BullMiletic/ProxistantVision/README.md

# ProxistantVision
Source files for BULL.MILETIC's installation [Proxistant Vision](https://bull.miletic.info/research/proxistant-vision).

Read about [Ferriscope](https://bull.miletic.info/works/ferriscope)

Read about [Venetie](https://bull.miletic.info/works/venetie-11111100001)
