BullMiletic/ProxistantVision/Ferriscope/datasheets/ArduinoMicroPinout.png

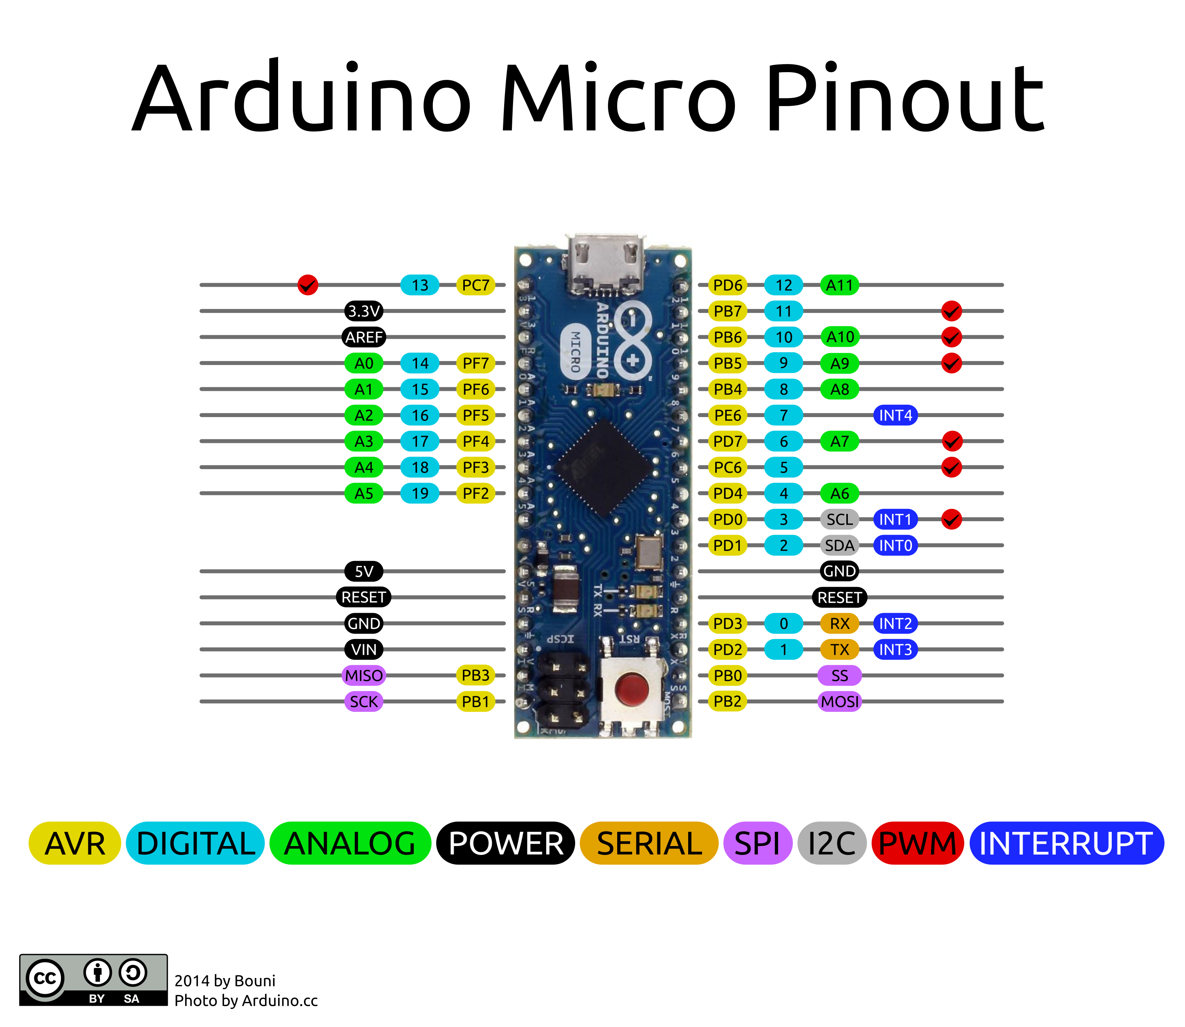
Ferriscope/datasheets/ArduinoMicroPinout.png
