BullMiletic/ProxistantVision/Ferriscope/PSI/kretskort/kontroller.png

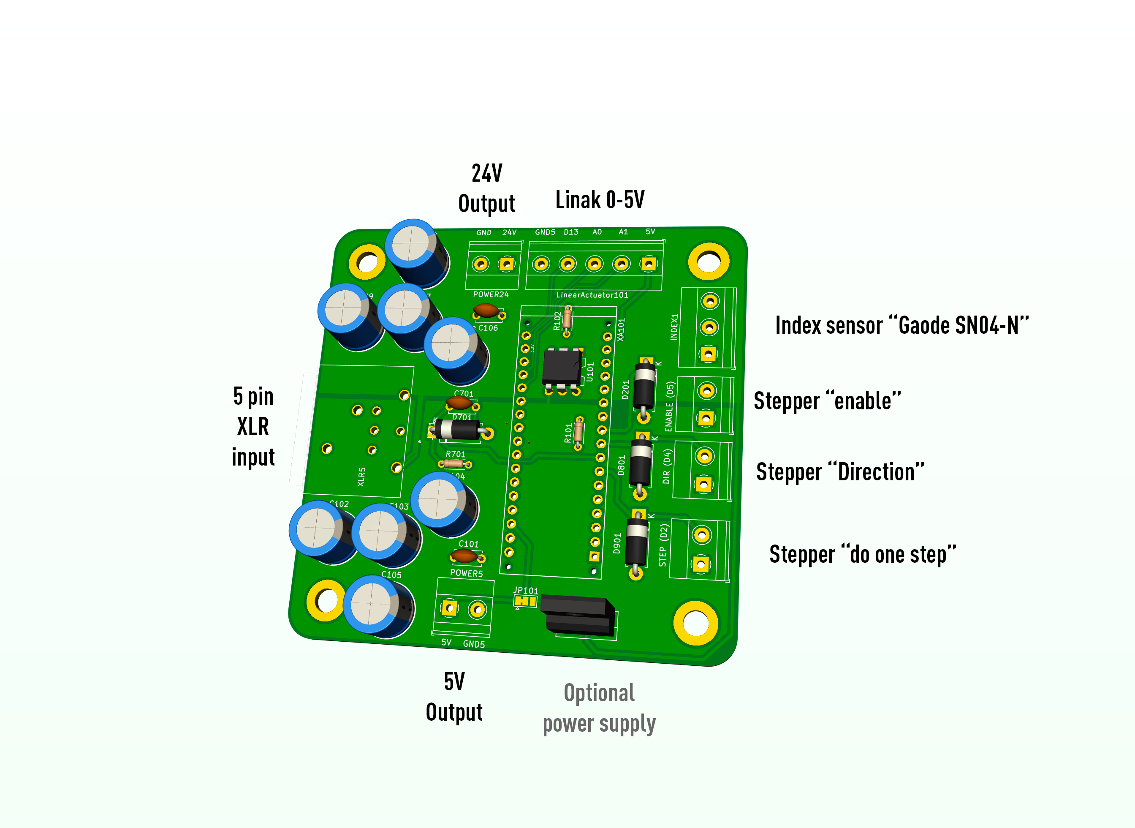
Ferriscope/PSI/kretskort/kontroller.png
