BullMiletic/ProxistantVision/Ferriscope/PSO/kretskort/generator.png

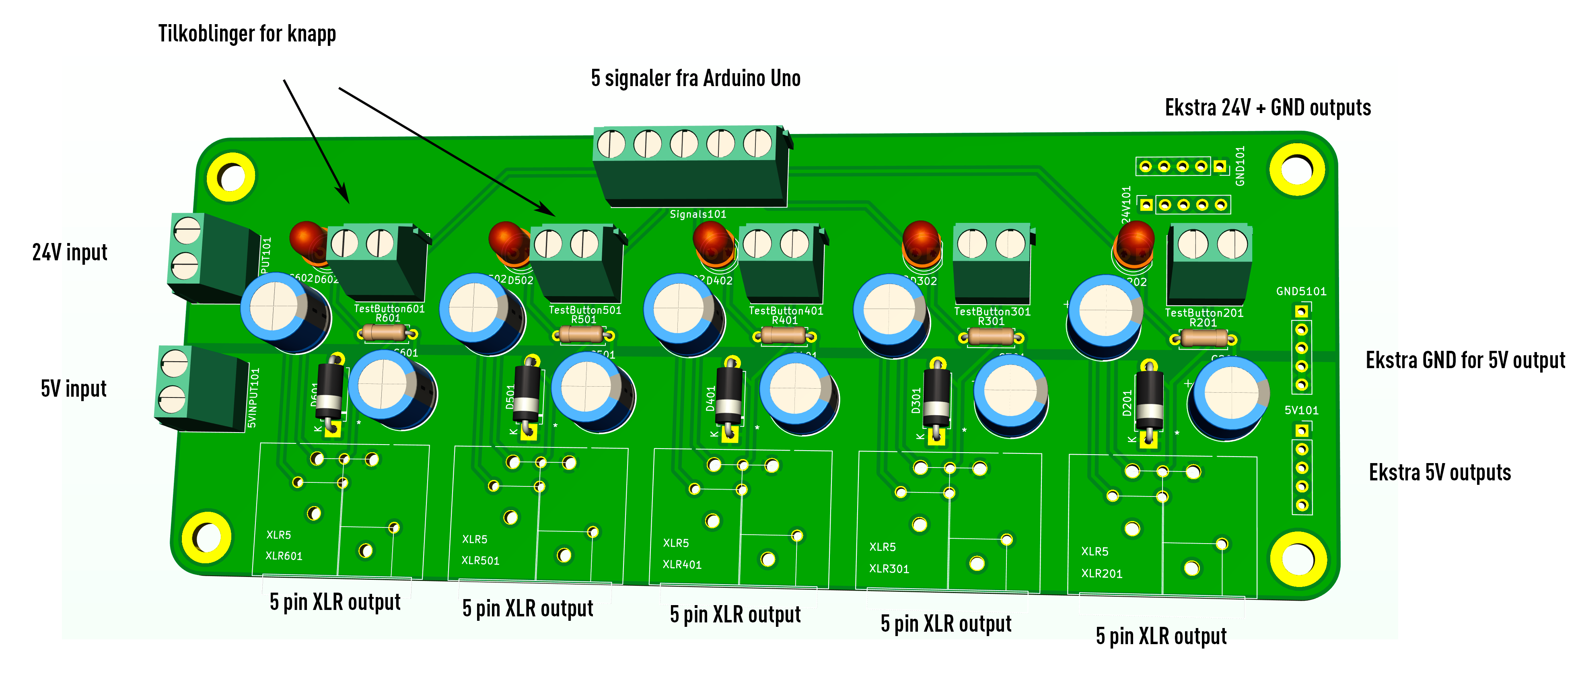
Ferriscope/PSO/kretskort/generator.png
