BullMiletic/ProxistantVision/Ferriscope/PSO/kretskort/Dec2021/generator-Edge_Cuts.dxf

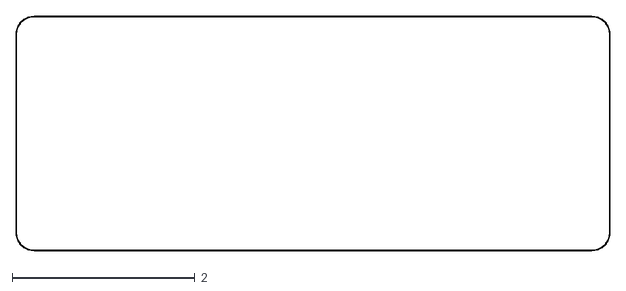
[picture p4: CAD file, 2022-08-10]
Ferriscope/PSO/kretskort/Dec2021/generator-Edge_Cuts.dxf
6.50 x 2.56
