BullMiletic/ProxistantVision/Ferriscope/PSO/kretskort/Jun2021/generator-F_Cu.dxf

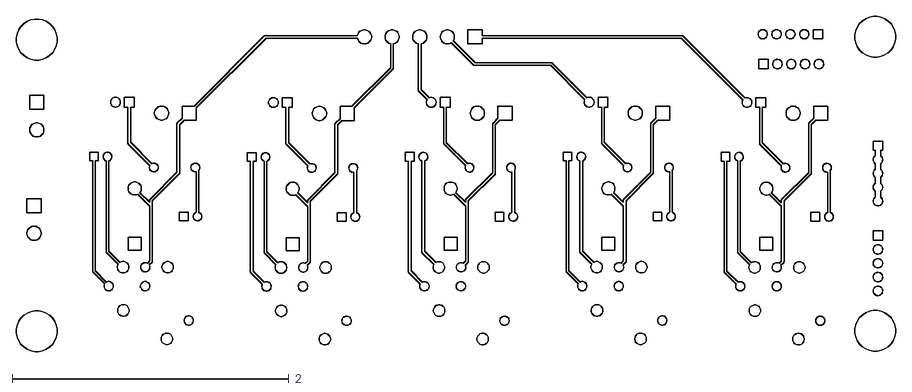
[picture p5: CAD file, 2022-08-10]
Ferriscope/PSO/kretskort/Jun2021/generator-F_Cu.dxf
6.36 x 2.42
