BullMiletic/ProxistantVision/Ferriscope/STEP/controll_box_universal.step

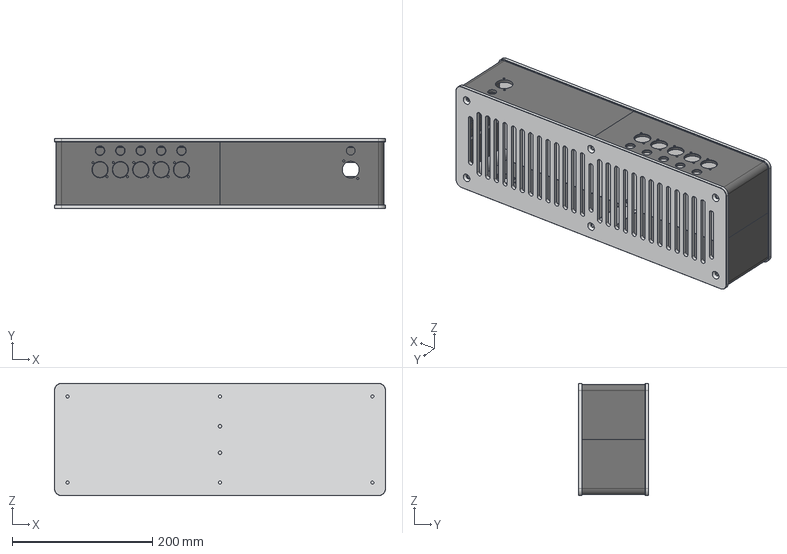
[picture p6: CAD file, 2022-10-25]
Ferriscope/STEP/controll_box_universal.step
471.3 x 100.0 x 160.0 mm
baseplate Chassis aluminium
electronics moiunting plate
top cover
3d printed sides
standoff
