BullMiletic/ProxistantVision/Venetie/STEP/venetie_mirror_flipper.step

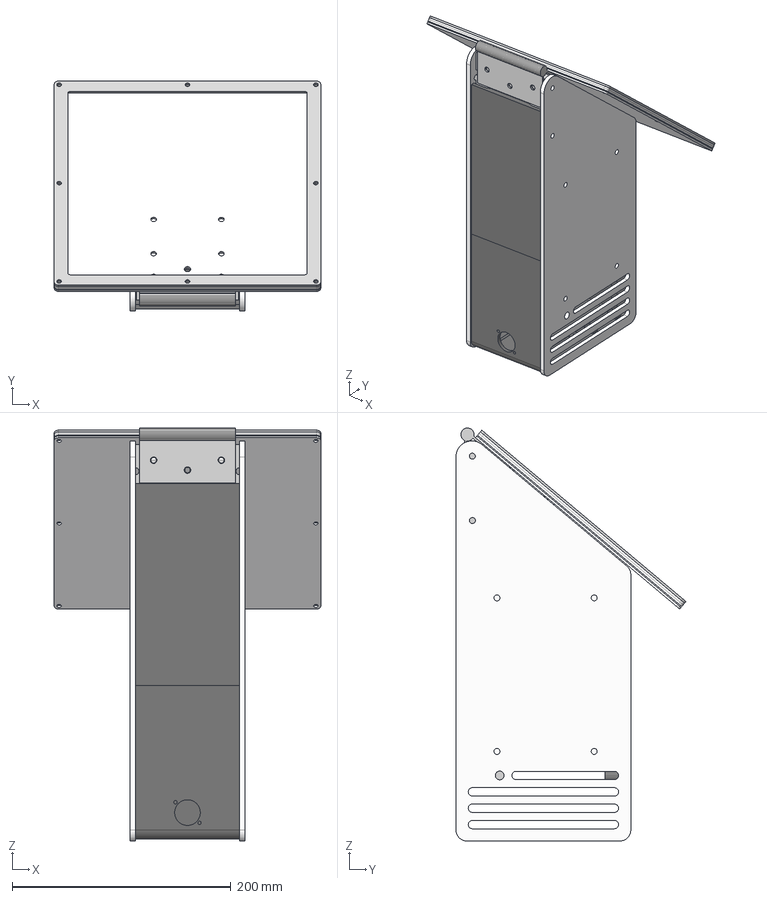
[picture p7: CAD file, 2022-10-25]
Venetie/STEP/venetie_mirror_flipper.step
244.0 x 210.5 x 378.0 mm
mirror side
device side
backing
distance x 2
piston mount
front cover
rod
spacer
piston mount(Mirror)
mirror cover
hinge mount beam
center joint spacer
rear mount
side panel
PIN
mount
side panel(Mirror)
rear spacer
cover
cover clamps
coverings
