BullMiletic/ProxistantVision/Ferriscope/PSO/kretskort/Dec2021/generator-F_Cu.dxf

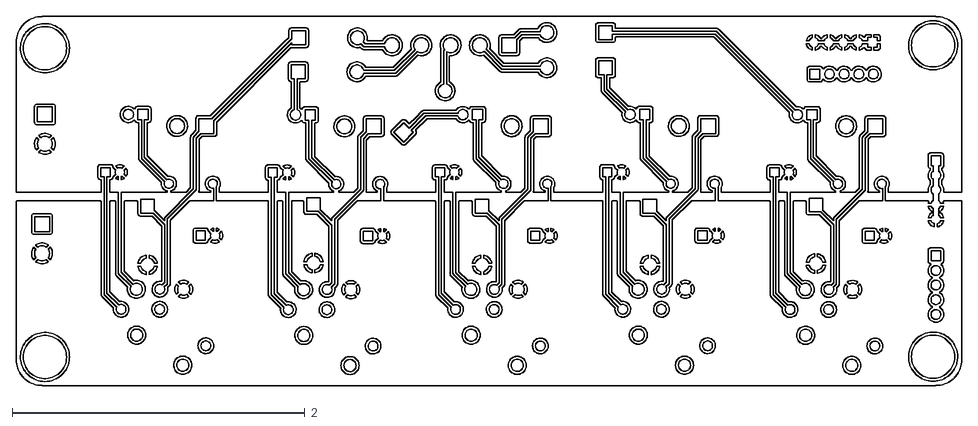
[picture p8: CAD file, 2022-08-10]
Ferriscope/PSO/kretskort/Dec2021/generator-F_Cu.dxf
6.46 x 2.52
