BullMiletic/ProxistantVision/Ferriscope/PSO/kretskort/Jun2021/generator-Edge_Cuts.dxf

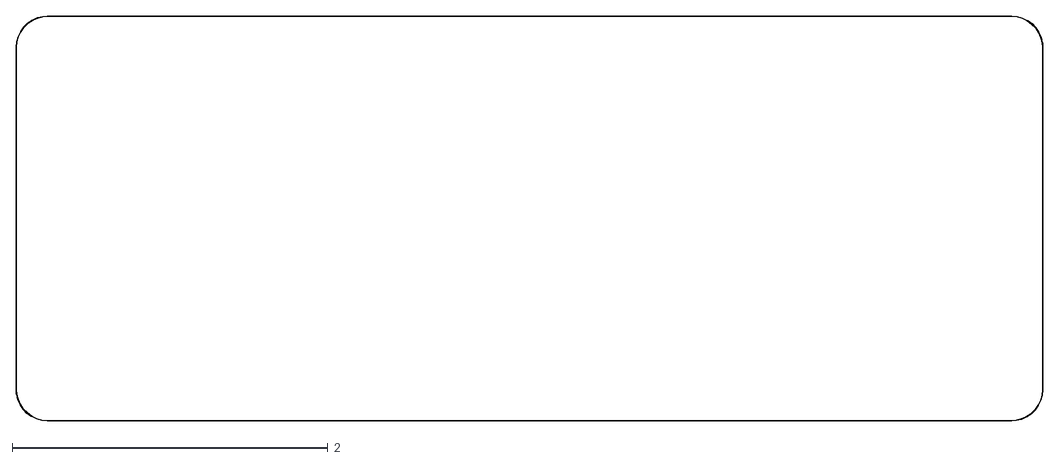
[picture p9: CAD file, 2022-08-10]
Ferriscope/PSO/kretskort/Jun2021/generator-Edge_Cuts.dxf
6.50 x 2.56
