BullMiletic/ProxistantVision/Venetie/STEP/venetie_rotating_solid.step

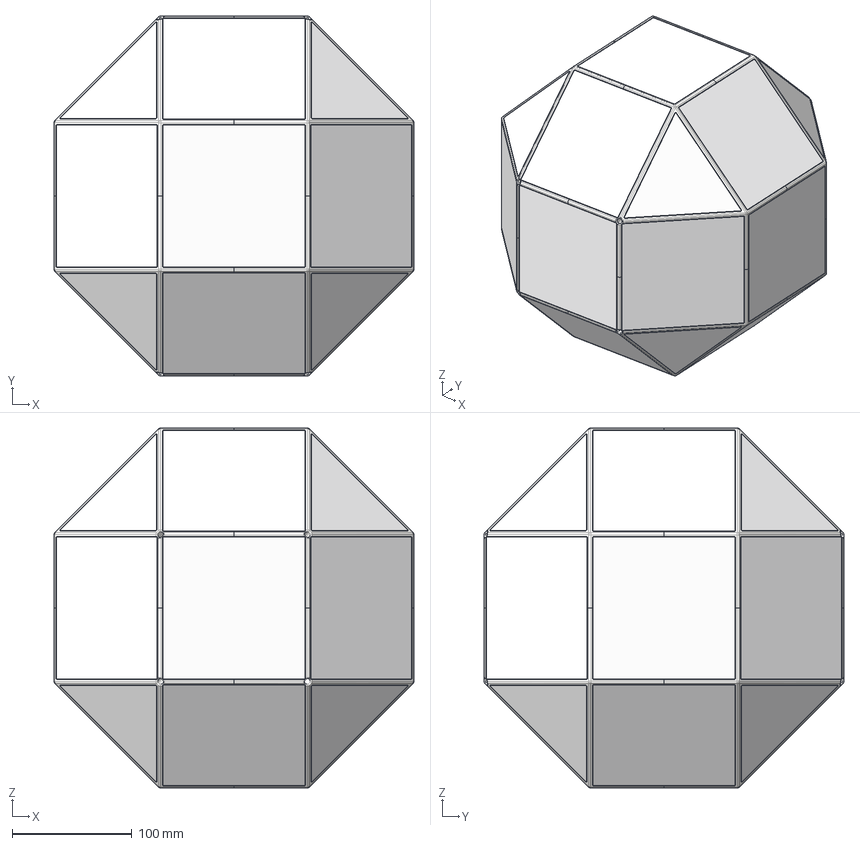
[picture p10: CAD file, 2022-10-25]
Venetie/STEP/venetie_rotating_solid.step
300.0 x 300.0 x 300.0 mm
SolidSection
SolidSection(Mirror)
SolidSection(Mirror) (1)
SolidSection(Mirror)(Mirror)
SolidSection(Mirror) (2)
SolidSection(Mirror)(Mirror) (1)
SolidSection(Mirror) (1)(Mirror)
SolidSection(Mirror)(Mirror)(Mirror)
rectangular mirrror x 17
triangular mirror x 4
triangular mirror(Mirror) x 4
