BullMiletic/ProxistantVision/Venetie/STEP/venetie_spinner_compact.step

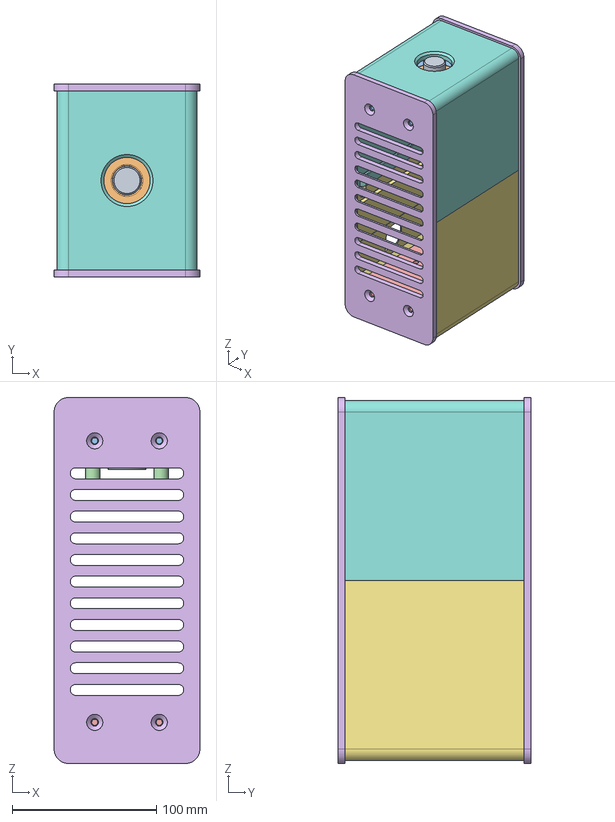
[picture p11: CAD file, 2022-10-25]
Venetie/STEP/venetie_spinner_compact.step
101.0 x 134.0 x 253.5 mm
shaft
bearing
front mount plate
motor mount x 4
end plate
bottom plate
covering
bottom plate(Mirror)
