BullMiletic/ProxistantVision/(list of files, cad)

Other CAD files:
Ferriscope/PSO/kretskort/Dec2021/generator-F_Silkscreen.dxf
