BullMiletic/ProxistantVision/Ferriscope/PSI/kretskort/kontroller/kontroller.pdf

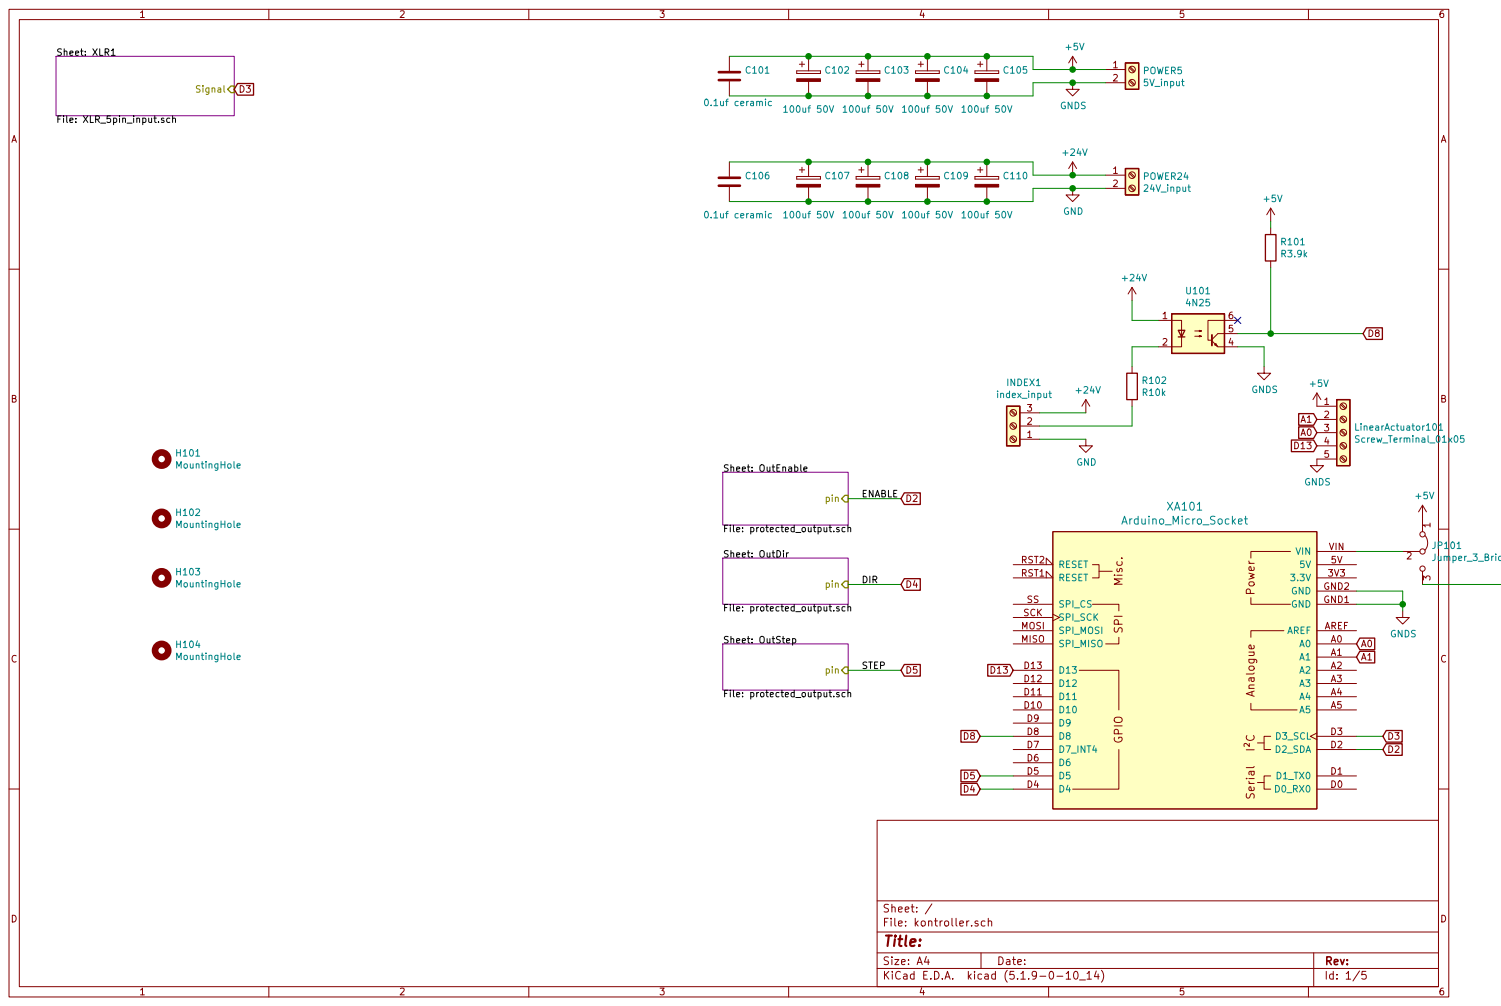
[picture p14: page 1]

Sheet: OutEnable File: protected_output.sch

pin Sheet: OutDir File: protected_output.sch

Id: 1/5 Title: File: kontroller.sch Sheet: /

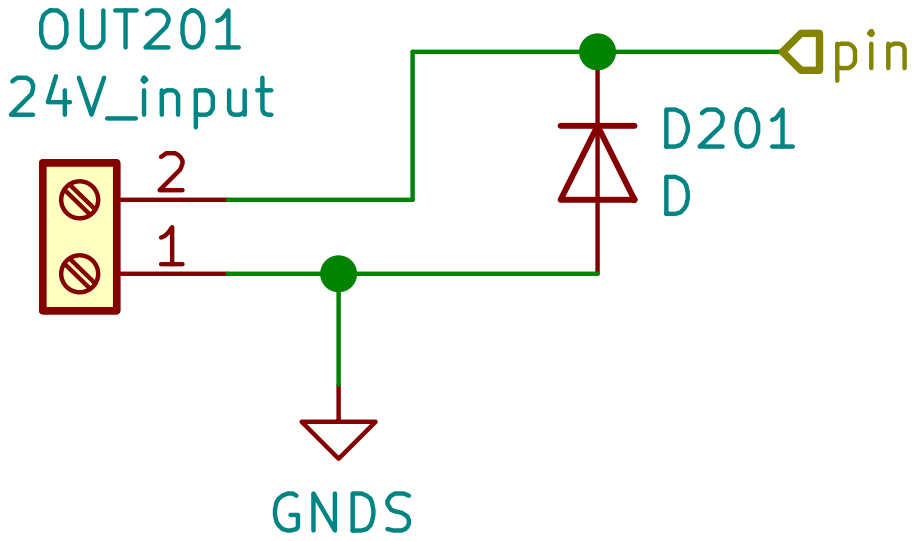
[picture p15: page 2]

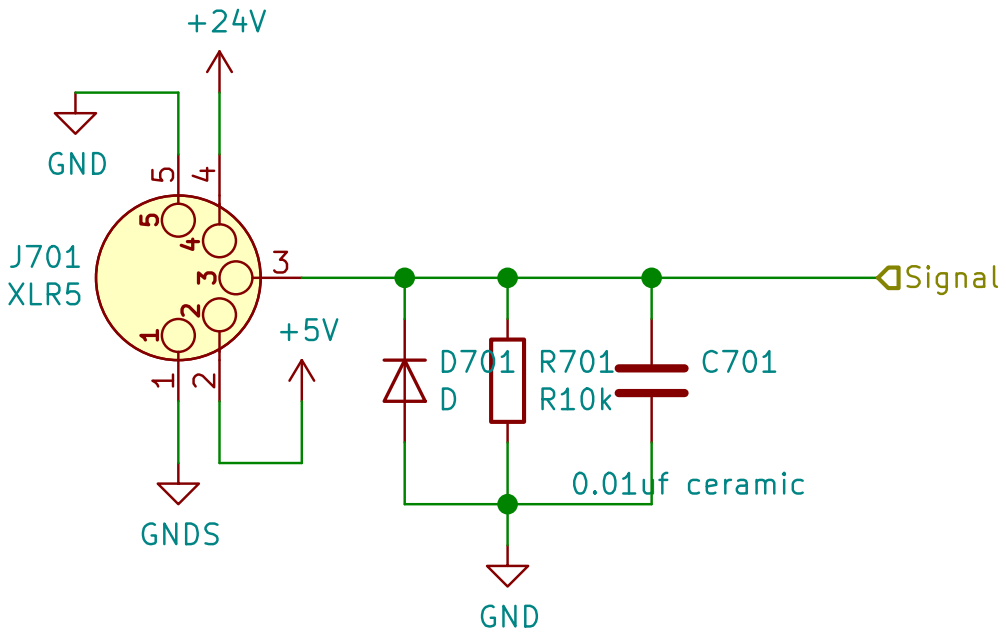
[picture p16: page 3]

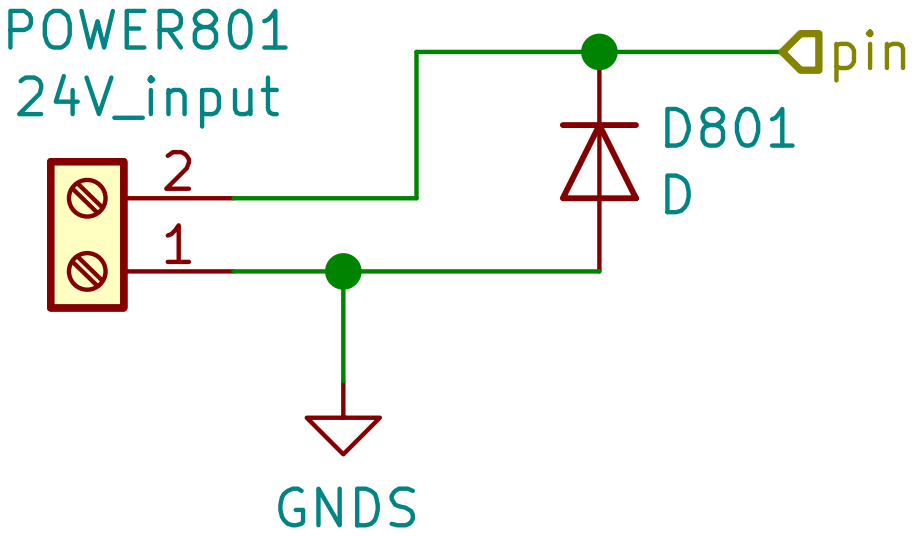
[picture p17: page 4]

File: protected_output.sch Sheet: /OutDir/
Id: 4/5 Title:

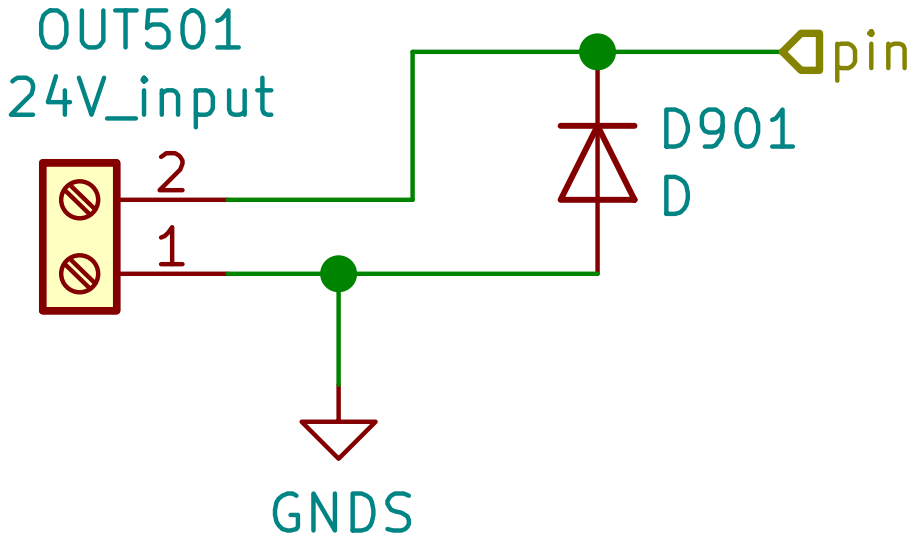
[picture p18: page 5]

File: protected_output.sch Sheet: /OutEnable/
Id: 5/5 Title:
