BullMiletic/ProxistantVision/Ferriscope/PSI/kretskort/PSI.pdf

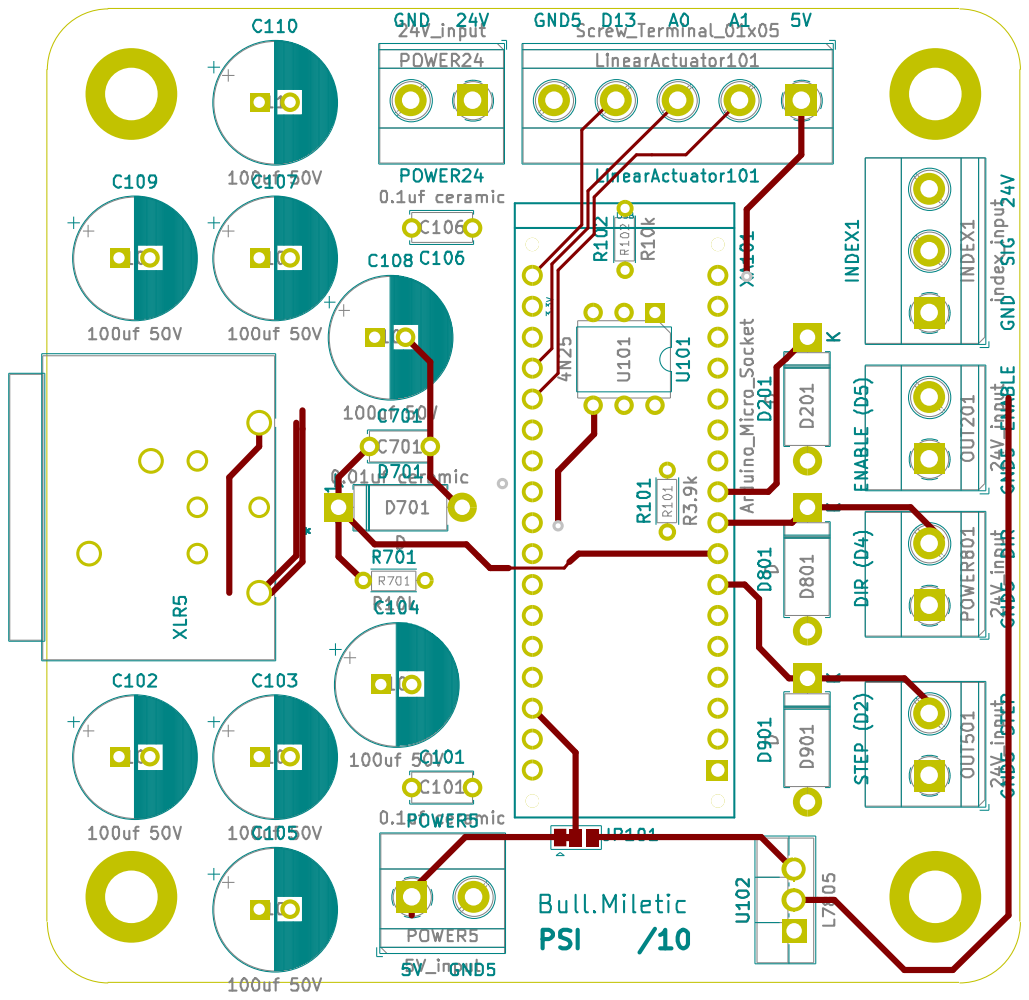
[picture p19: page 1]
