BullMiletic/ProxistantVision/Ferriscope/PSO/kretskort/PSO.pdf

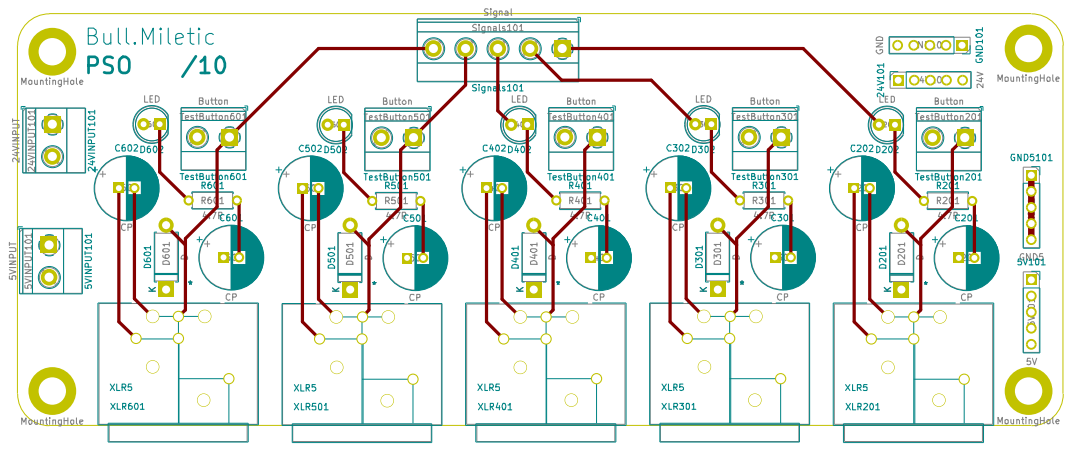
[picture p20: page 1]
