BullMiletic/ProxistantVision/Ferriscope/PSI/kretskort/kontroller/kontroller.kicad_pcb

## KiCad design Ferriscope/PSI/kretskort/kontroller/kontroller.kicad_pcb (2022-08-10)

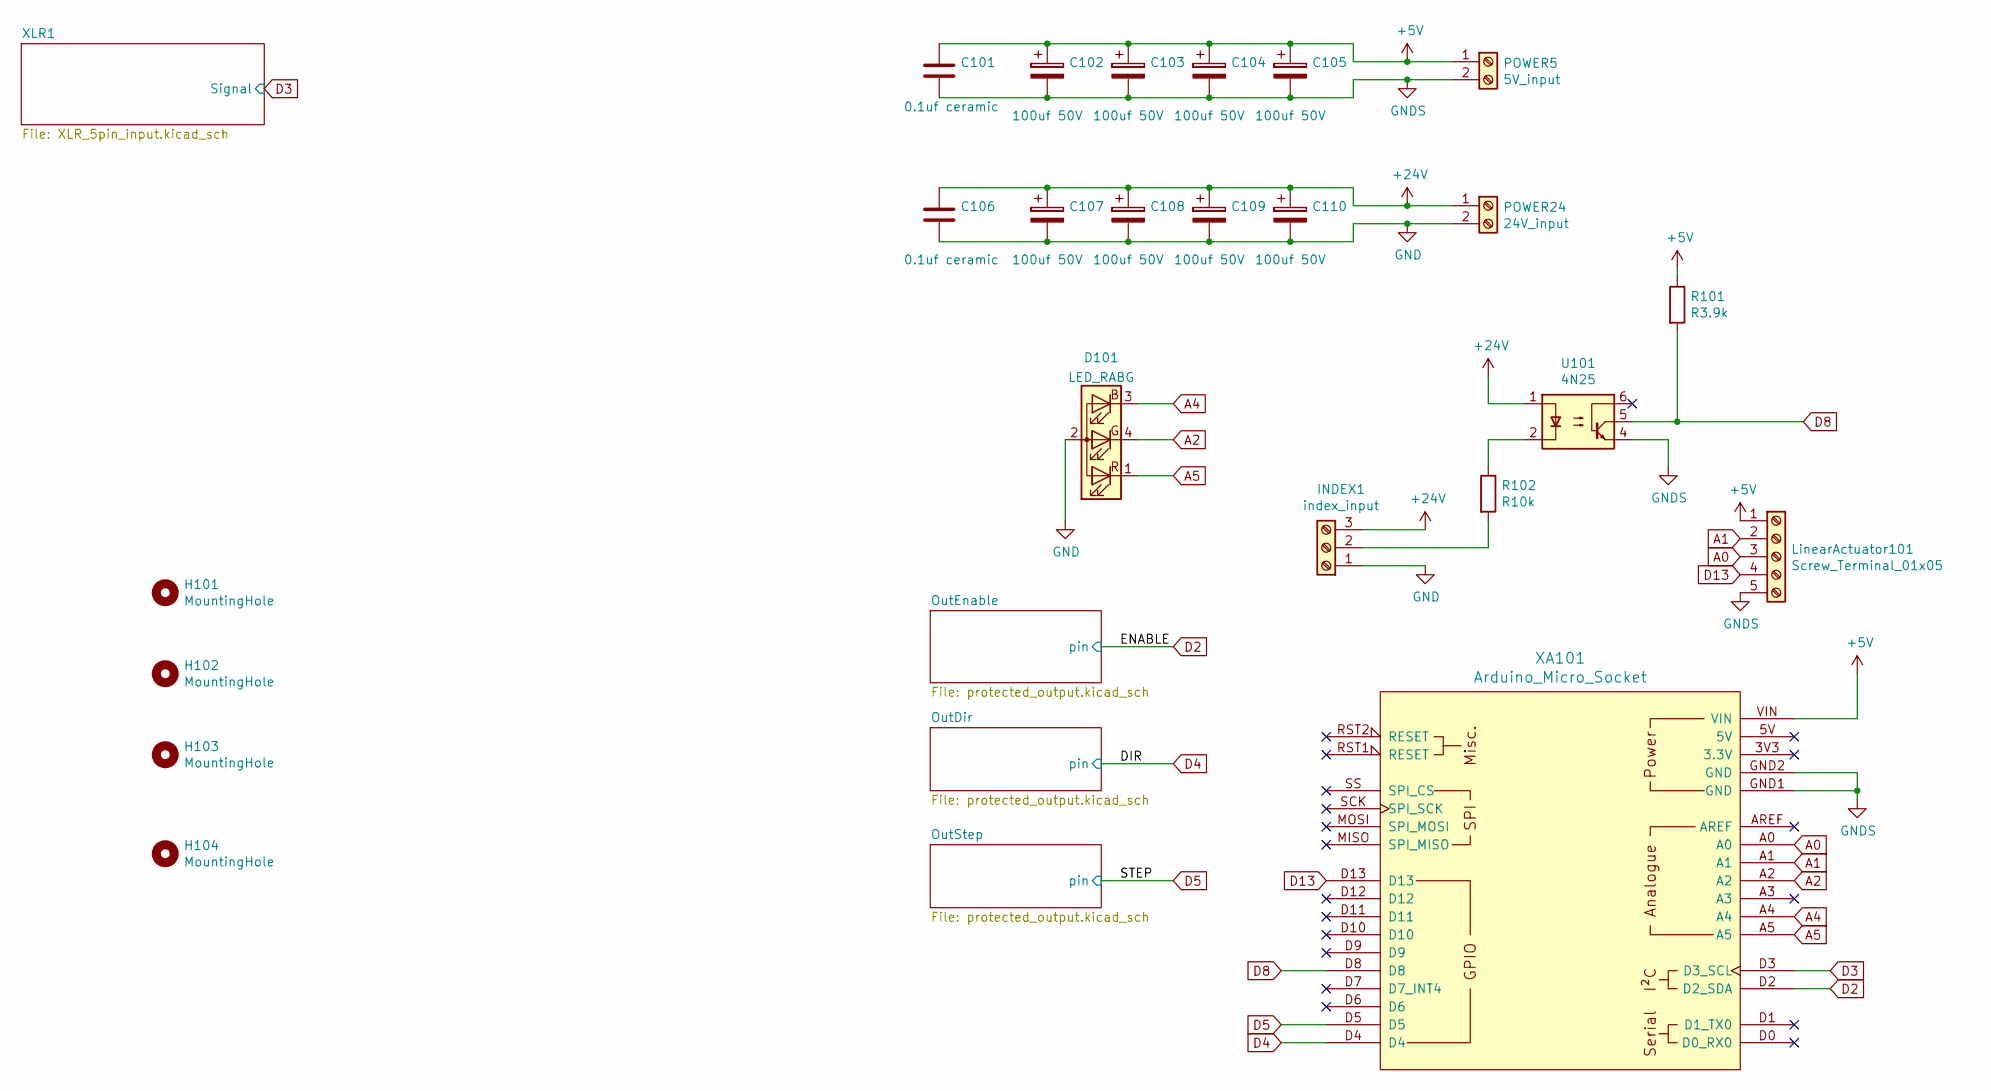
[picture p21: schematic kontroller.kicad_sch]

Parts:
C101, C106: 0.1uf ceramic; C_Disc_D5.0mm_W2.5mm_P5.00mm; MPN C322C104K5R5TA
C102, C103, C104, C105, C107, C108, C109, C110: 100uf 50V; CP_Radial_D10.0mm_P2.50mm; MPN ECE-A1HN101U
D101: LED_RABG; LED_D5.0mm-4_RGB
H101, H102, H103, H104: MountingHole; MountingHole_4.3mm_M4_DIN965_Pad
INDEX1: index_input; TerminalBlock_Phoenix_MKDS-1,5-3-5.08_1x03_P5.08mm_Horizont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; MPN 1729131
LinearActuator101: Screw_Terminal_01x05; TerminalBlock_Phoenix_MKDS-1,5-5-5.08_1x05_P5.08mm_Horizont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; MPN 1729157
POWER5: 5V_input; TerminalBlock_Phoenix_MKDS-1,5-2-5.08_1x02_P5.08mm_Horizont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; MPN 1729128
POWER24: 24V_input; TerminalBlock_Phoenix_MKDS-1,5-2-5.08_1x02_P5.08mm_Horizont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; MPN 1729128
R101: R3.9k; R_Axial_DIN0204_L3.6mm_D1.6mm_P5.08mm_Horizontal
R102: R10k; R_Axial_DIN0204_L3.6mm_D1.6mm_P5.08mm_Horizontal
U101: 4N25; DIP-6_W7.62mm
XA101: Arduino_Micro_Socket

Connections:
+5V: C101.1, C102.1, C103.1, C104.1, C105.1, LinearActuator101.1, POWER5.1, R101.1, XA101.VIN; also elsewhere on the board
+24V: C106.1, C107.1, C108.1, C109.1, C110.1, INDEX1.3, POWER24.1, U101.1; also elsewhere on the board
A0: LinearActuator101.3, XA101.A0
A1: LinearActuator101.2, XA101.A1
A2: D101.4 (GK), XA101.A2
A4: D101.3 (BK), XA101.A4
A5: D101.1 (RK), XA101.A5
D2: XA101.D2 (D2_SDA); also elsewhere on the board
D3: XA101.D3 (D3_SCL); also elsewhere on the board
D8: R101.2, U101.5, XA101.D8
D13: LinearActuator101.4, XA101.D13
GND: C106.2, C107.2, C108.2, C109.2, C110.2, D101.2 (A), INDEX1.1, POWER24.2; also elsewhere on the board
GNDS: C101.2, C102.2, C103.2, C104.2, C105.2, LinearActuator101.5, POWER5.2, U101.4, XA101.GND1 (GND), XA101.GND2 (GND); also elsewhere on the board
unnamed: INDEX1.2, R102.2
unnamed: R102.1, U101.2

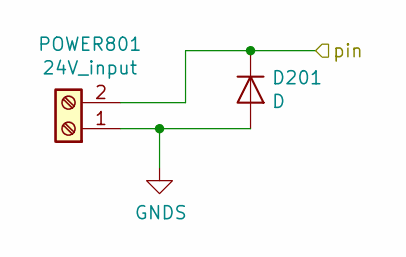
[picture p22: schematic protected_output.kicad_sch]

Parts:
D201: D; D_DO-15_P10.16mm_Horizontal; MPN SA5.0A
POWER801: 24V_input; TerminalBlock_Phoenix_MKDS-1,5-2-5.08_1x02_P5.08mm_Horizont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; MPN 1729128

Connections:
GNDS: D201.2 (A), POWER801.1; also elsewhere on the board

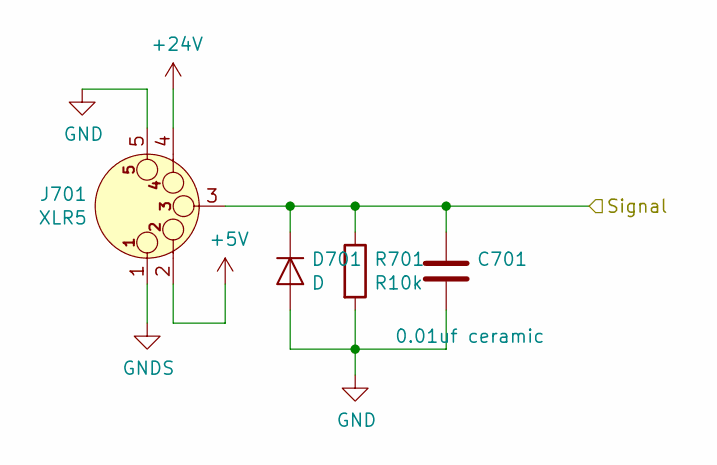
[picture p23: schematic XLR_5pin_input.kicad_sch]

Parts:
C701: 0.01uf ceramic; C_Disc_D5.0mm_W2.5mm_P5.00mm; MPN 10000PF
D701: D; D_DO-15_P10.16mm_Horizontal; MPN SA5.0A
J701: XLR5; IO-XLR5-M-EH; MPN IO-XLR5-M-EH
R701: R10k; R_Axial_DIN0204_L3.6mm_D1.6mm_P5.08mm_Horizontal

Connections:
+5V: J701.2; also elsewhere on the board
+24V: J701.4 (P3); also elsewhere on the board
D3: C701.1, D701.1 (K), J701.3, R701.1; also elsewhere on the board
GND: C701.2, D701.2 (A), J701.5, R701.2; also elsewhere on the board
GNDS: J701.1; also elsewhere on the board

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
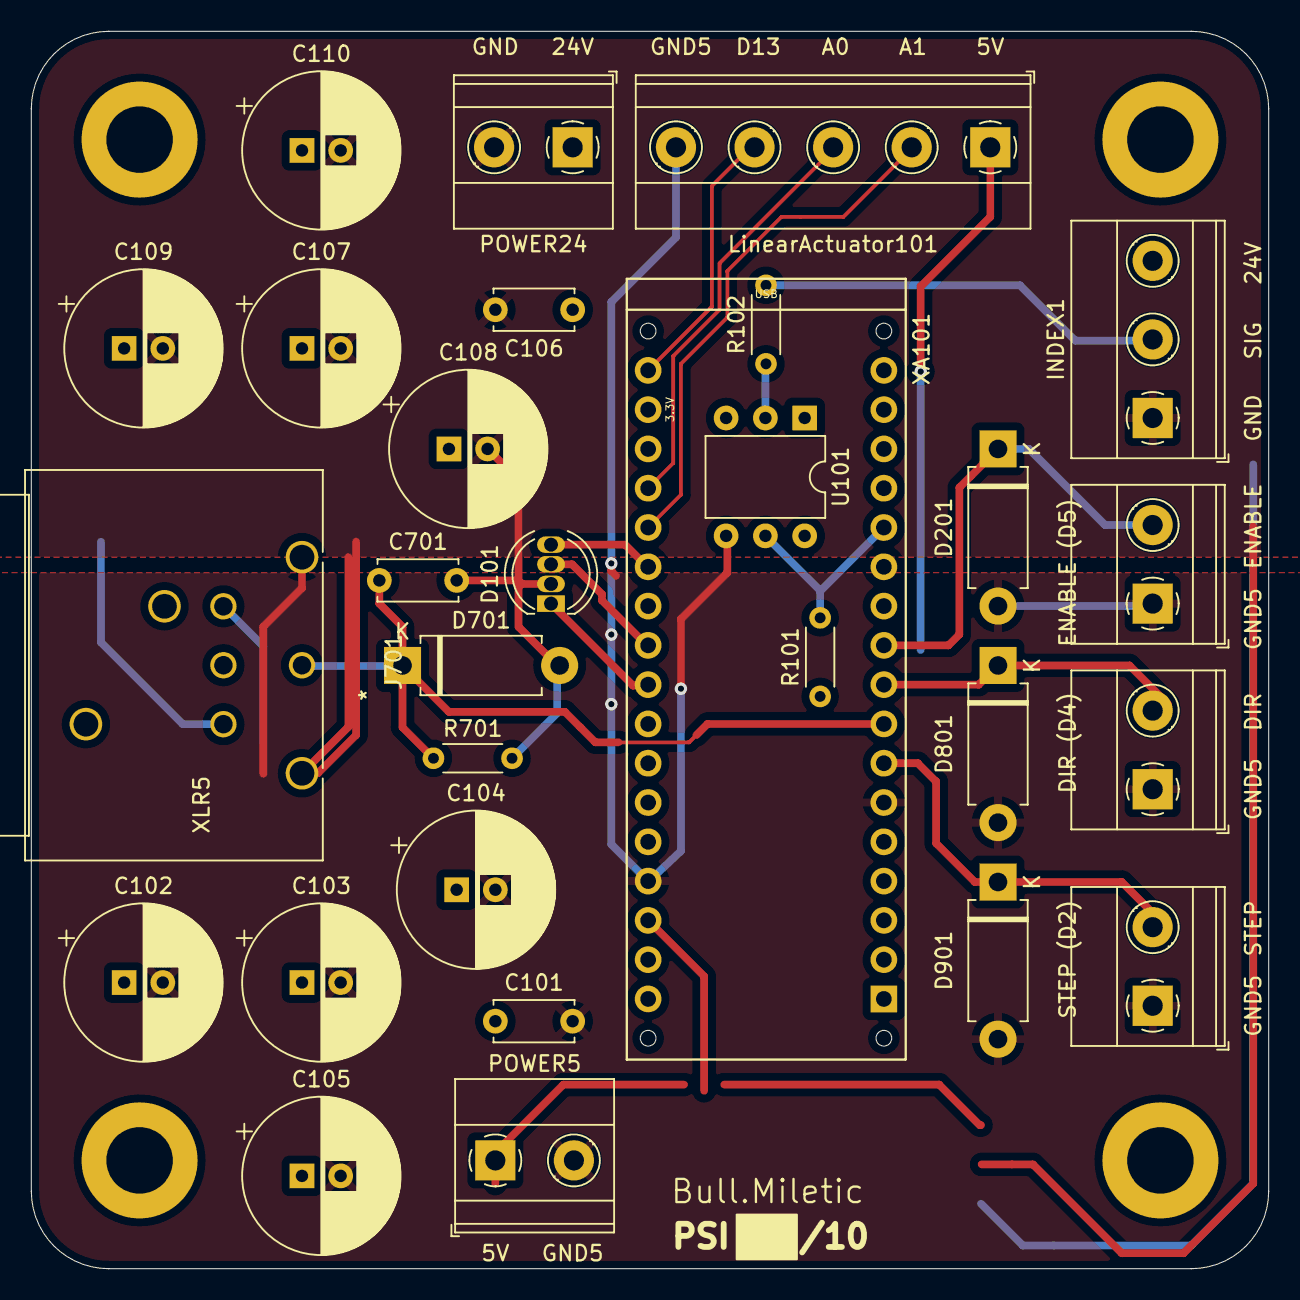
[picture p24: board kontroller.kicad_pcb from above]

Board: 2 copper layers, 80.0 x 80.0 mm, 33 parts (0 on the bottom side), 17 nets.

Other parts of the board:
D801, D901: D; D_DO-15_P10.16mm_Horizontal
OUT201, OUT501: 24V_input; TerminalBlock_Phoenix_MKDS-1,5-2-5.08_1x02_P5.08mm_Horizont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

Their connections:
D2: D901.1 (K), OUT501.2; also elsewhere on the board
GNDS: D801.2 (A), D901.2 (A), OUT201.1, OUT501.1; also elsewhere on the board
