BullMiletic/ProxistantVision/Ferriscope/PSO/kretskort/generator.kicad_pcb

## KiCad design Ferriscope/PSO/kretskort/generator.kicad_pcb (2022-08-10)

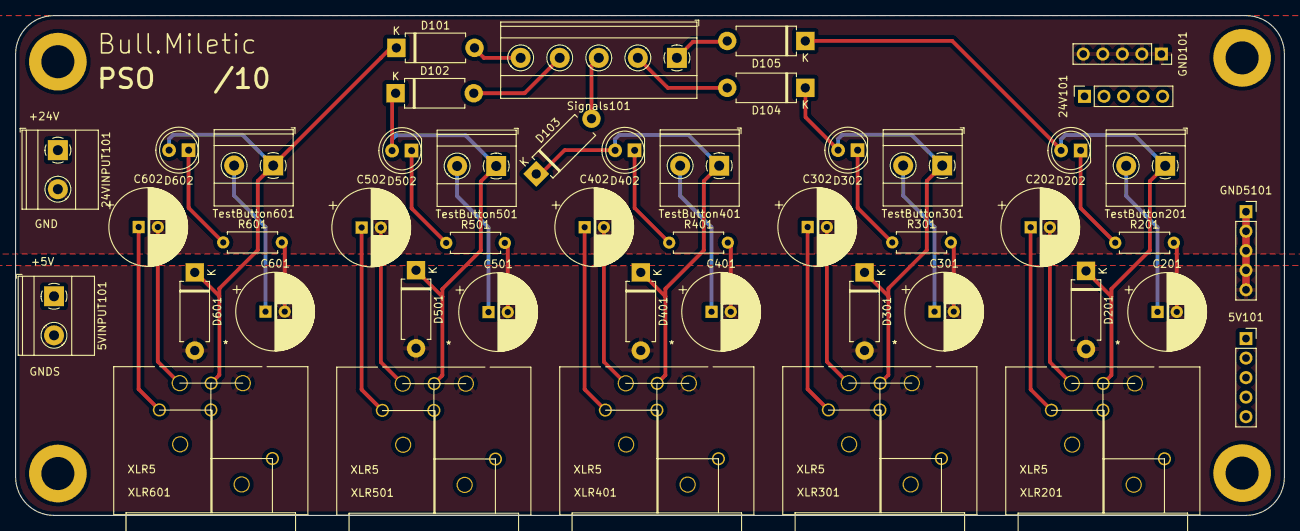
[picture p25: board generator.kicad_pcb from above]

Board: 2 copper layers, 165.0 x 65.0 mm, 52 parts (0 on the bottom side), 19 nets.

Parts:
5V101: 5V; PinSocket_1x05_P2.54mm_Vertical
5VINPUT101: 5VINPUT; TerminalBlock_Phoenix_MKDS-1,5-2-5.08_1x02_P5.08mm_Horizont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
24V101: 24V; PinSocket_1x05_P2.54mm_Vertical
24VINPUT101: 24VINPUT; TerminalBlock_Phoenix_MKDS-1,5-2-5.08_1x02_P5.08mm_Horizont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
C201, C202, C301, C302, C401, C402, C501, C502, C601, C602: CP; CP_Radial_D10.0mm_P2.50mm
D101, D102, D103, D104, D105, D201, D301, D401, D501, D601: D; D_DO-15_P10.16mm_Horizontal
D202, D302, D402, D502, D602: LED; LED_D5.0mm
GND101: GND; PinSocket_1x05_P2.54mm_Vertical
GND5101: GND5; PinSocket_1x05_P2.54mm_Vertical
H101, H102, H103, H104: MountingHole; MountingHole_4.3mm_M4_DIN965_Pad
H105: Image; globe
R201, R301, R401, R501, R601: 4.7R; R_Axial_DIN0207_L6.3mm_D2.5mm_P7.62mm_Horizontal
Signals101: Signal; TerminalBlock_Phoenix_MKDS-1,5-5-5.08_1x05_P5.08mm_Horizont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
TestButton201, TestButton301, TestButton401, TestButton501, TestButton601: Button; TerminalBlock_Phoenix_MKDS-1,5-2-5.08_1x02_P5.08mm_Horizont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
XLR201, XLR301, XLR401, XLR501, XLR601: XLR5; IO-XLR5-F-EH

Connections:
+5V: 5V101.1, 5V101.2, 5V101.3, 5V101.4, 5V101.5, 5VINPUT101.1, C201.1, C301.1, C401.1, C501.1, C601.1, TestButton201.2, TestButton301.2, TestButton401.2, TestButton501.2, TestButton601.2, XLR201.2, XLR301.2, XLR401.2, XLR501.2, XLR601.2
+24V: 24V101.1, 24V101.2, 24V101.3, 24V101.4, 24V101.5, 24VINPUT101.1, C202.1, C302.1, C402.1, C502.1, C602.1, XLR201.4 (P3), XLR301.4 (P3), XLR401.4 (P3), XLR501.4 (P3), XLR601.4 (P3)
GND: 24VINPUT101.2, C202.2, C302.2, C402.2, C502.2, C602.2, GND101.1, GND101.2, GND101.3, GND101.4, GND101.5, XLR201.5, XLR301.5, XLR401.5, XLR501.5, XLR601.5
GNDS: 5VINPUT101.2, C201.2, C301.2, C401.2, C501.2, C601.2, D201.2 (A), D301.2 (A), D401.2 (A), D501.2 (A), D601.2 (A), GND5101.1, GND5101.2, GND5101.3, GND5101.4, GND5101.5, R201.2, R301.2, R401.2, R501.2, R601.2, XLR201.1, XLR301.1, XLR401.1, XLR501.1, XLR601.1
unnamed: D202.1 (K), R201.1
unnamed: D302.1 (K), R301.1
unnamed: D402.1 (K), R401.1
unnamed: D502.1 (K), R501.1
unnamed: D602.1 (K), R601.1
unnamed: D105.2 (A), Signals101.1
unnamed: D104.2 (A), Signals101.2
unnamed: D103.2 (A), Signals101.3
unnamed: D102.2 (A), Signals101.4
unnamed: D101.2 (A), Signals101.5
S1: D105.1 (K), D201.1 (K), D202.2 (A), TestButton201.1, XLR201.3
S2: D104.1 (K), D301.1 (K), D302.2 (A), TestButton301.1, XLR301.3
S3: D103.1 (K), D401.1 (K), D402.2 (A), TestButton401.1, XLR401.3
S4: D102.1 (K), D501.1 (K), D502.2 (A), TestButton501.1, XLR501.3
S5: D101.1 (K), D601.1 (K), D602.2 (A), TestButton601.1, XLR601.3
