BullMiletic/ProxistantVision/(commit log)

2022-08-10 Source files backup for easy sharing
    [XLR-output.kicad_sch, XLR-output.sch, XLR_5pin_input.kicad_sch, XLR_5pin_input.sch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]
2022-09-20 Timer tweaks + support for pot to adjust speed
